Sidsolegend/CANIS/docs/images/01-prototype-chassis-side.jpg

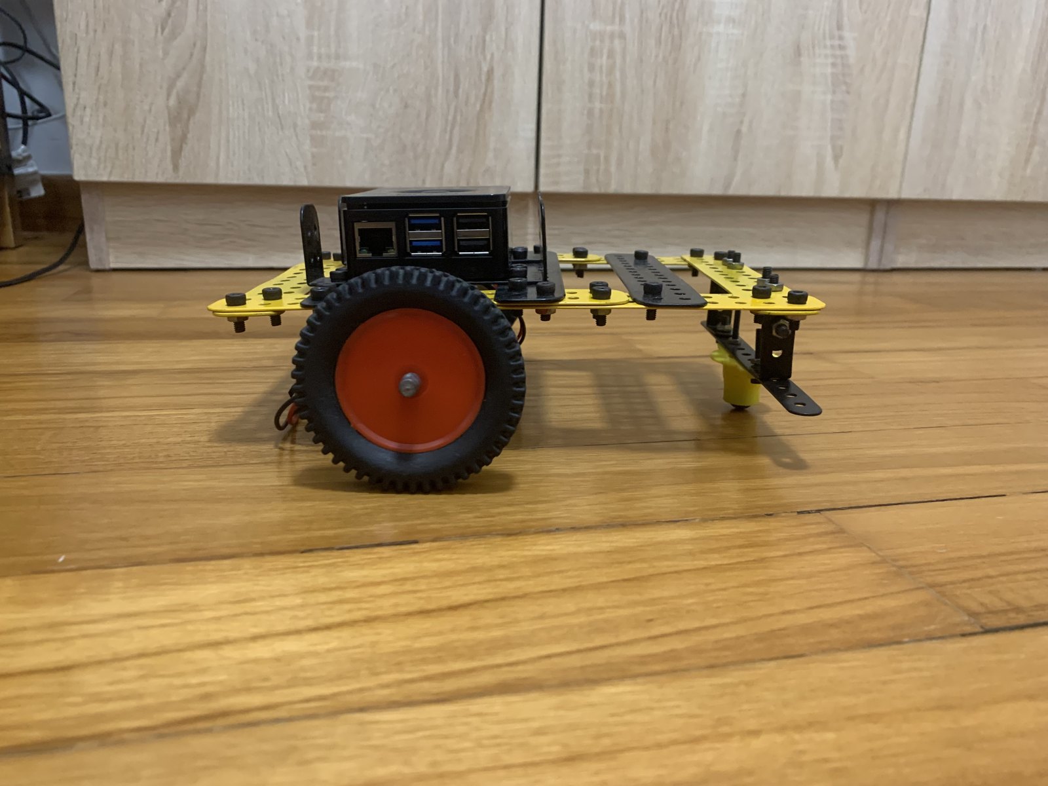
docs/images/01-prototype-chassis-side.jpg
