Sidsolegend/CANIS/hardware/cad/preview_v4/v4_shell_front.png

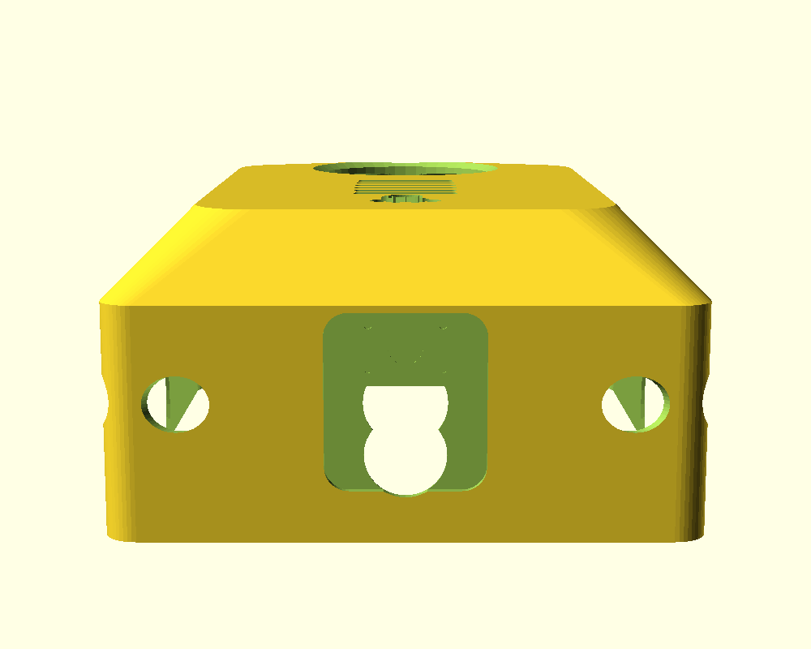
hardware/cad/preview_v4/v4_shell_front.png
