Sidsolegend/CANIS/hardware/cad/preview_v4/v4_shell_iso.png

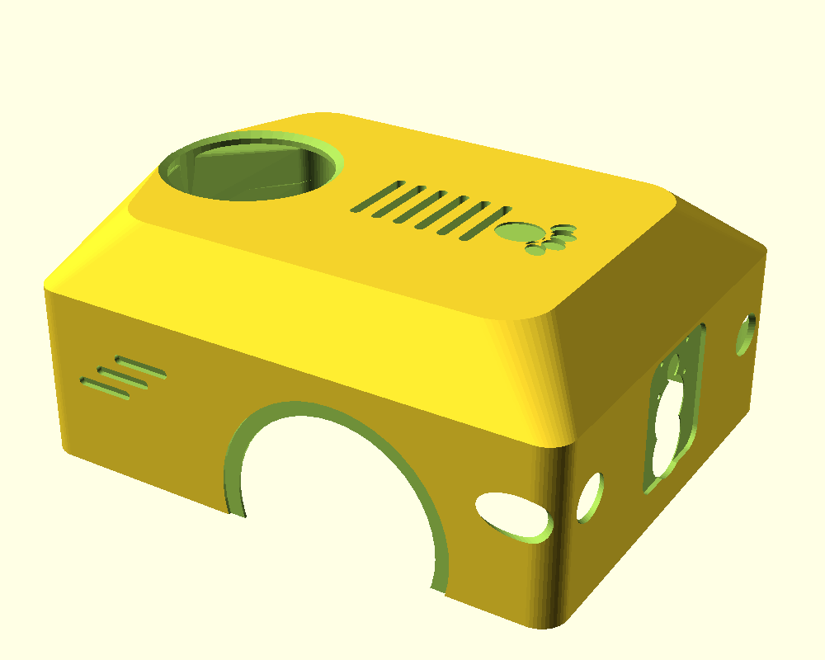
hardware/cad/preview_v4/v4_shell_iso.png
