Sidsolegend/CANIS/hardware/cad/preview_v4/v4_shell_top.png

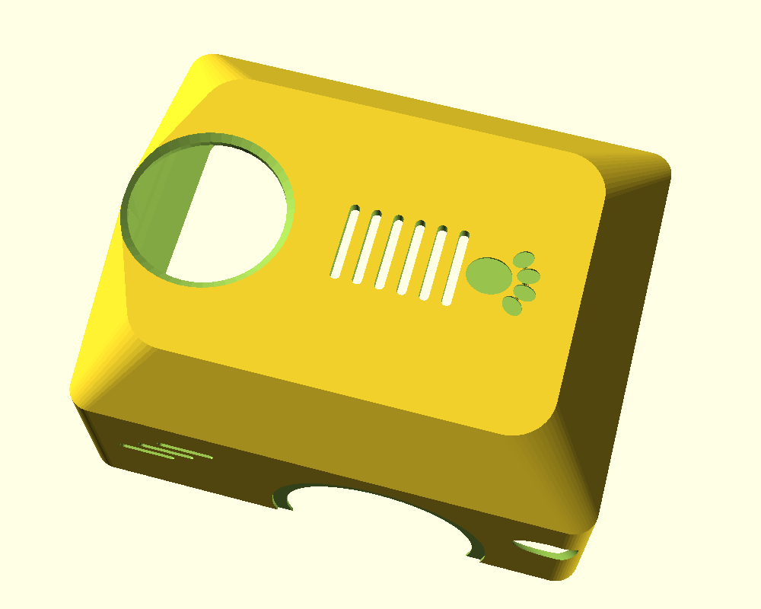
hardware/cad/preview_v4/v4_shell_top.png
