Sidsolegend/CANIS/hardware/cad/renders_v4_front.png

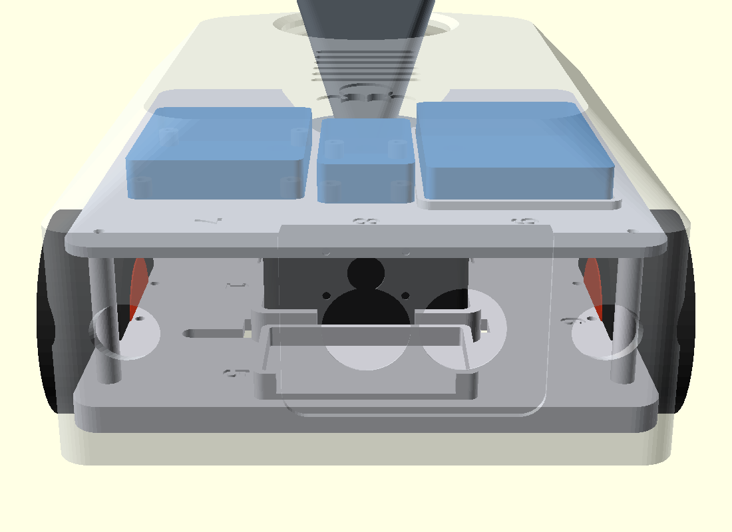
hardware/cad/renders_v4_front.png
