Sidsolegend/CANIS/hardware/cad/renders_v4_plate.png

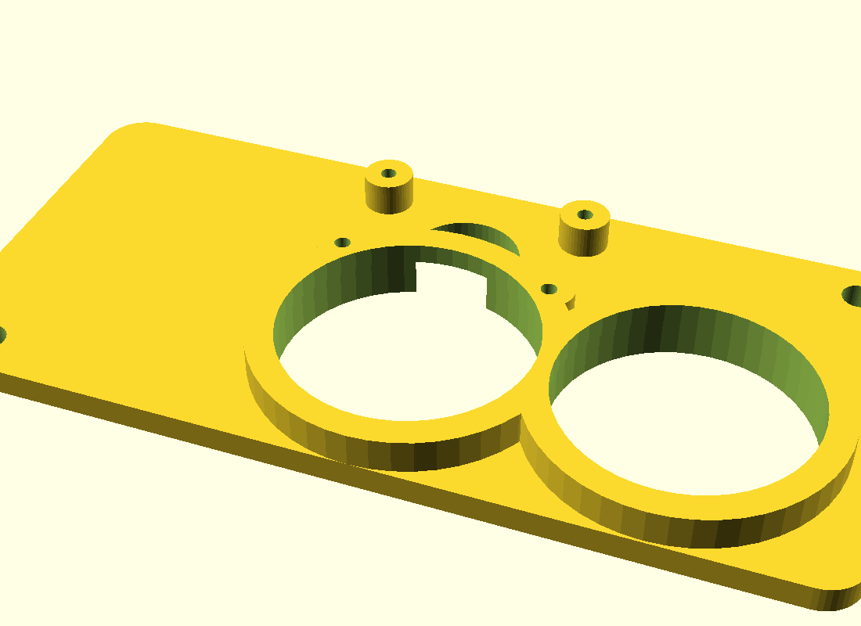
hardware/cad/renders_v4_plate.png
