Sidsolegend/CANIS/hardware/pcb/canis_main_preview.png

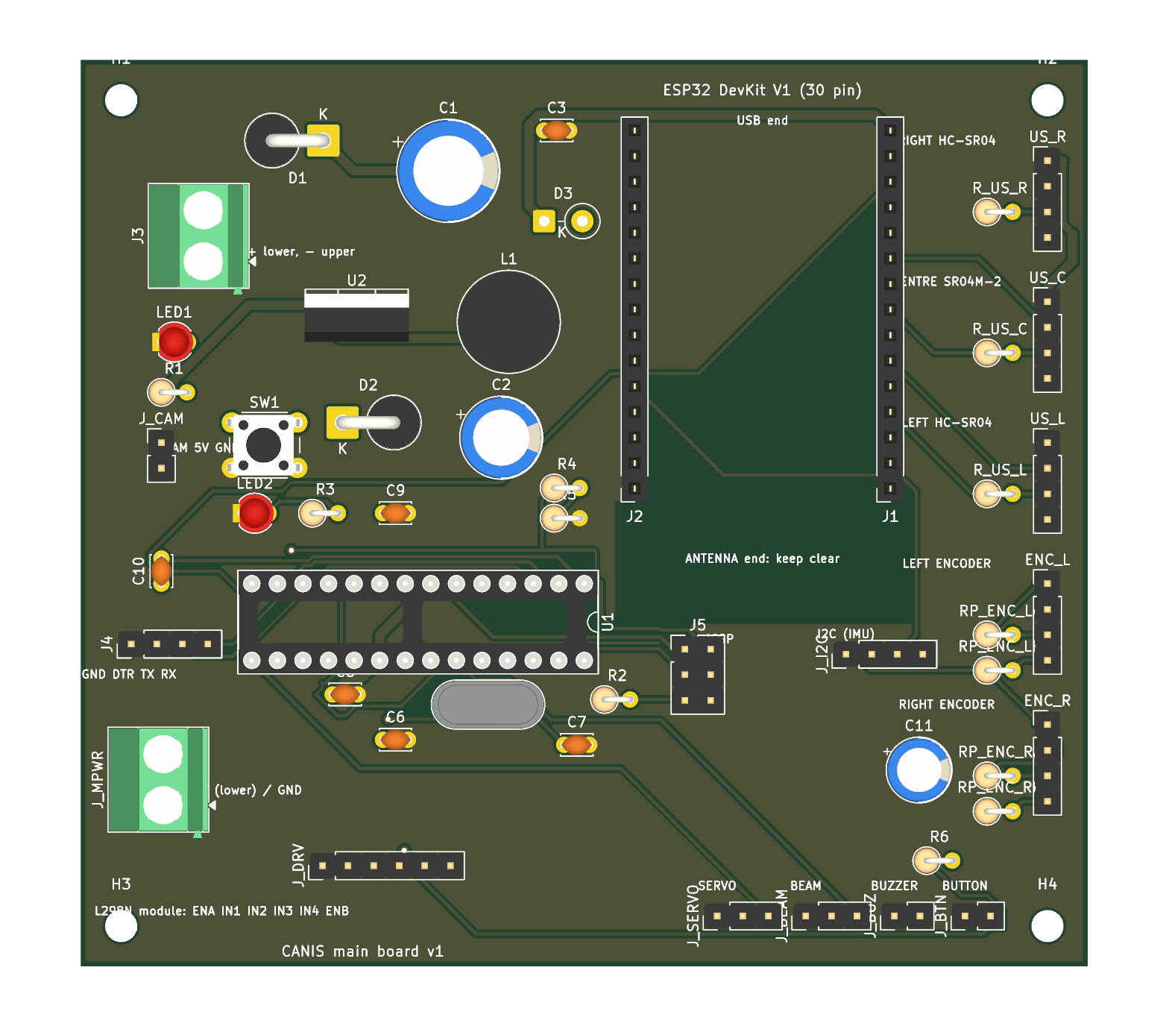
hardware/pcb/canis_main_preview.png
