Sidsolegend/CANIS/hardware/cad/stl/canis_all.stl

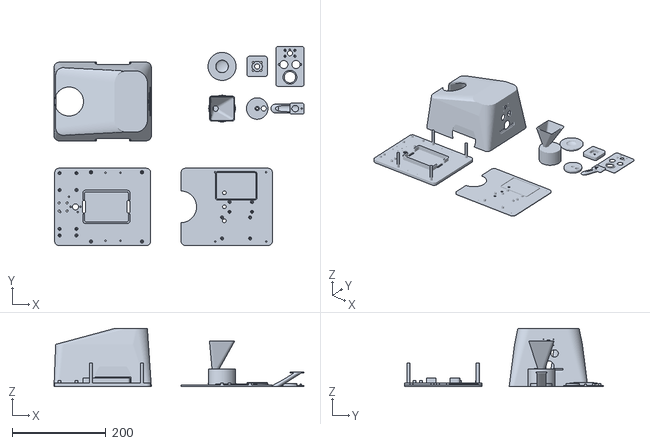
[picture p18: CAD file, 2026-10-11]
hardware/cad/stl/canis_all.stl
534.0 x 425.0 x 124.0
