Sidsolegend/CANIS/hardware/cad/stl_v4/lid.stl

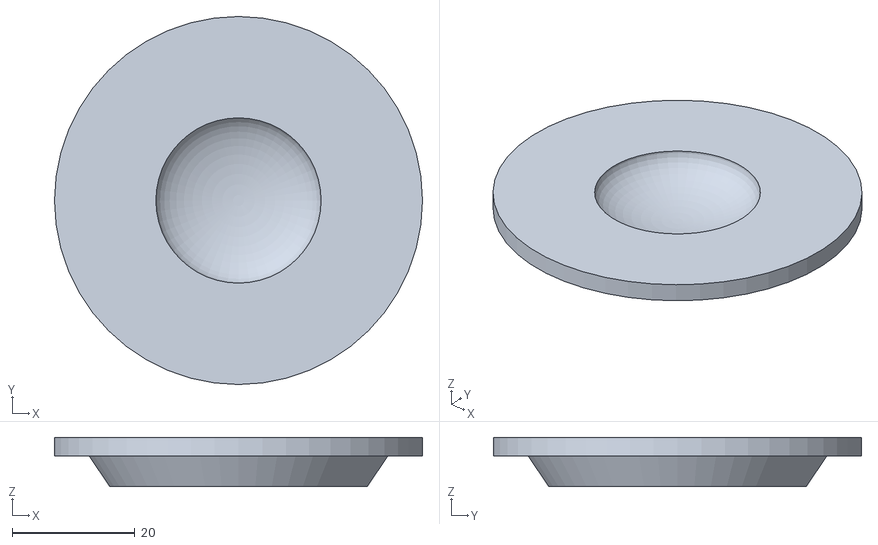
[picture p19: CAD file, 2026-10-11]
hardware/cad/stl_v4/lid.stl
60.0 x 60.0 x 8.00
