Sidsolegend/CANIS/hardware/cad/stl/chute.stl

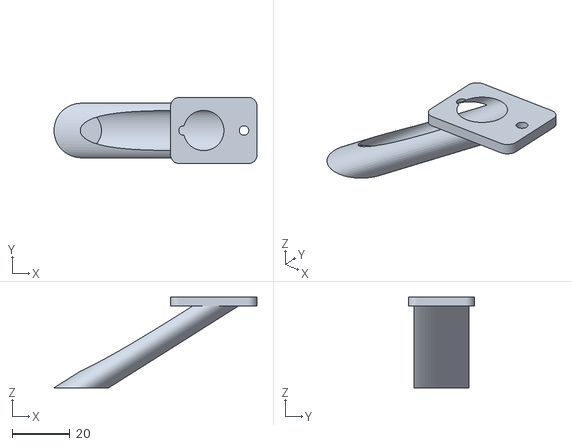
[picture p21: CAD file, 2026-06-29]
hardware/cad/stl/chute.stl
70.5 x 23.0 x 31.5
