Sidsolegend/CANIS/hardware/cad/stl_v4/shell_B.stl

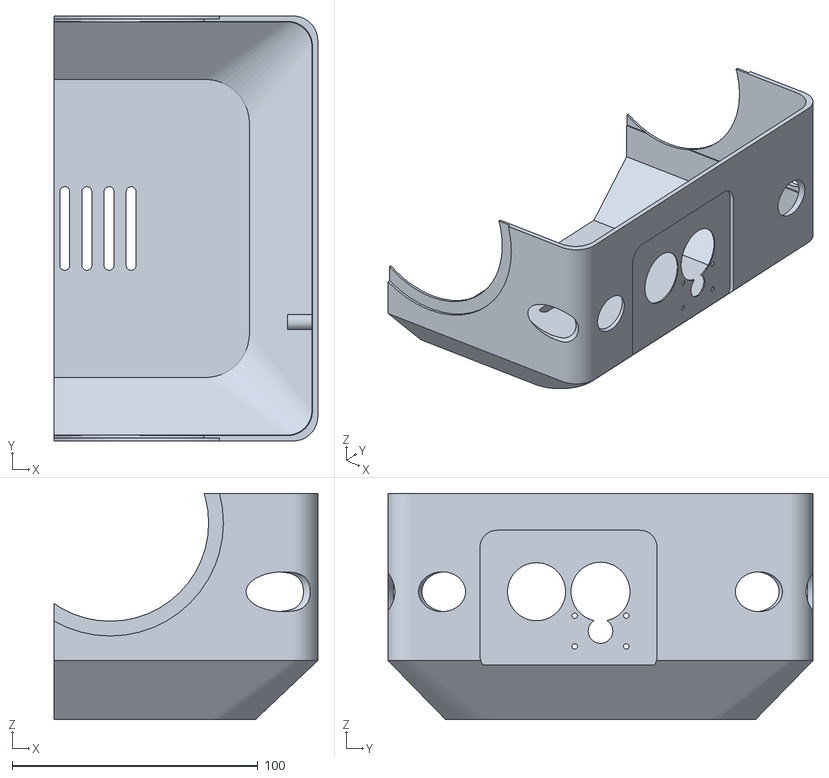
[picture p22: CAD file, 2026-10-11]
hardware/cad/stl_v4/shell_B.stl
107.2 x 172.8 x 92.0
