Sidsolegend/CANIS/hardware/cad/stl/shelf.stl

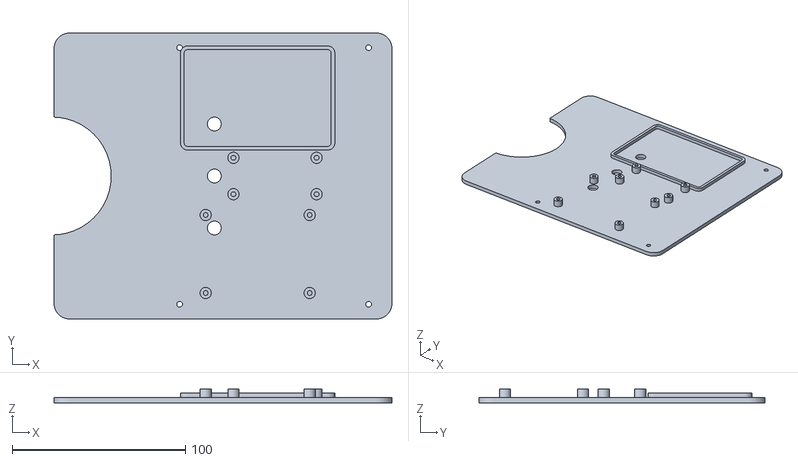
[picture p23: CAD file, 2026-06-29]
hardware/cad/stl/shelf.stl
195.0 x 165.0 x 8.00
