Sidsolegend/CANIS/printables/deck_onepiece.gcode.3mf

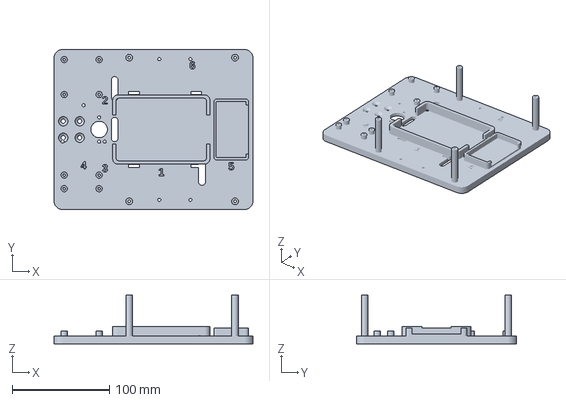
[picture p24: CAD file, 2026-07-19]
printables/deck_onepiece.gcode.3mf
205.0 x 165.0 x 50.0 mm
