Sidsolegend/CANIS/hardware/cad/stl/lid.stl

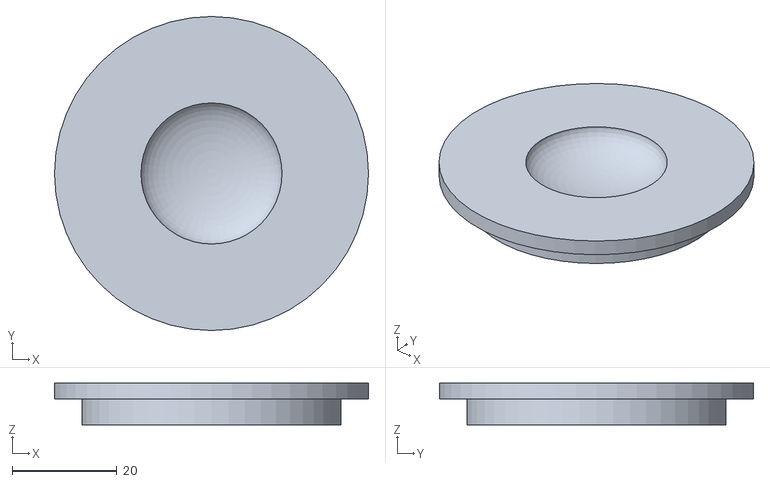
[picture p25: CAD file, 2026-06-29]
hardware/cad/stl/lid.stl
60.0 x 60.0 x 8.00
