Sidsolegend/CANIS/hardware/cad/stl_v4/shelf.stl

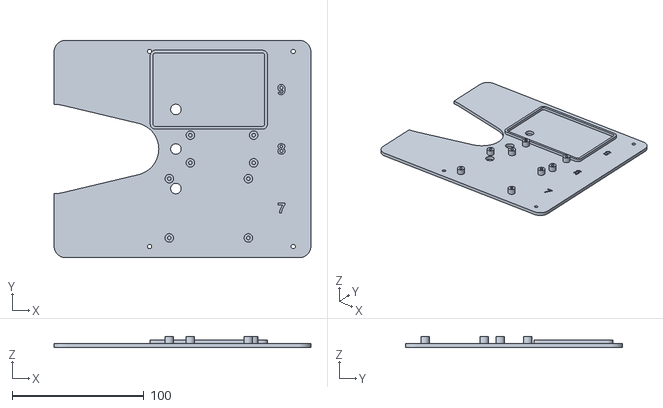
[picture p26: CAD file, 2026-10-11]
hardware/cad/stl_v4/shelf.stl
195.0 x 165.0 x 8.00
