Sidsolegend/CANIS/printables/deck_B.gcode.3mf

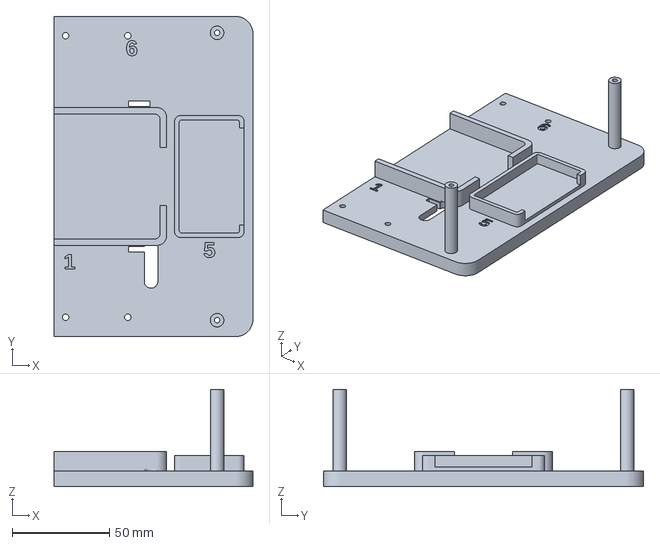
[picture p27: CAD file, 2026-07-19]
printables/deck_B.gcode.3mf
102.5 x 165.0 x 50.0 mm
