Sidsolegend/CANIS/hardware/cad/stl/shell.stl

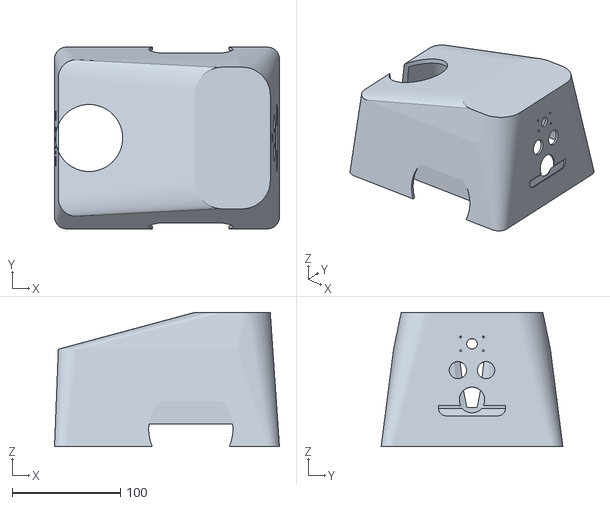
[picture p28: CAD file, 2026-06-29]
hardware/cad/stl/shell.stl
208.0 x 168.0 x 124.0
