Sidsolegend/CANIS/hardware/cad/stl_v4/shell.stl

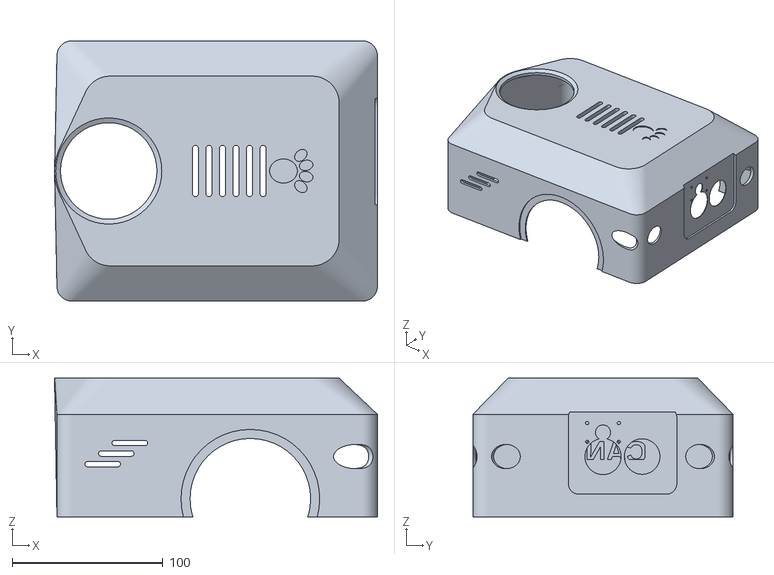
[picture p29: CAD file, 2026-10-11]
hardware/cad/stl_v4/shell.stl
214.4 x 172.8 x 92.0
