Sidsolegend/CANIS/hardware/cad/stl/deck.stl

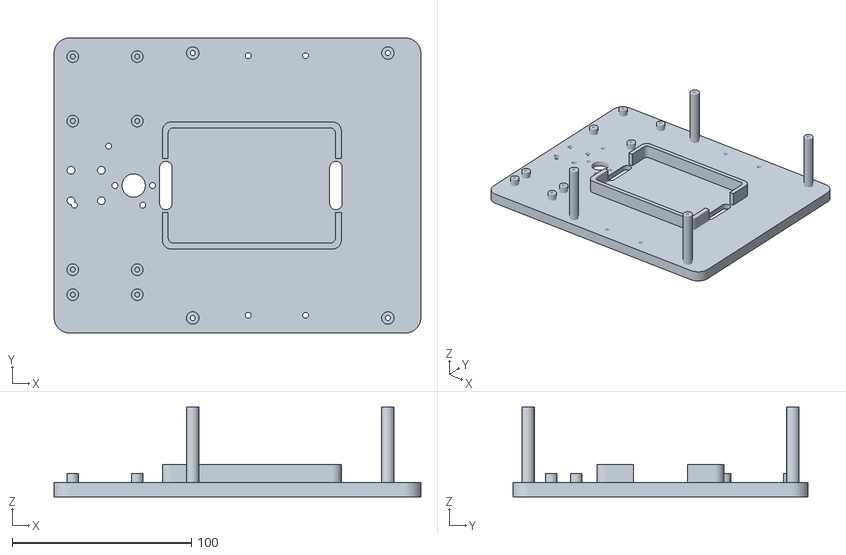
[picture p30: CAD file, 2026-06-29]
hardware/cad/stl/deck.stl
205.0 x 165.0 x 50.0
