Sidsolegend/CANIS/hardware/cad/stl_v4/dispenser_base.stl

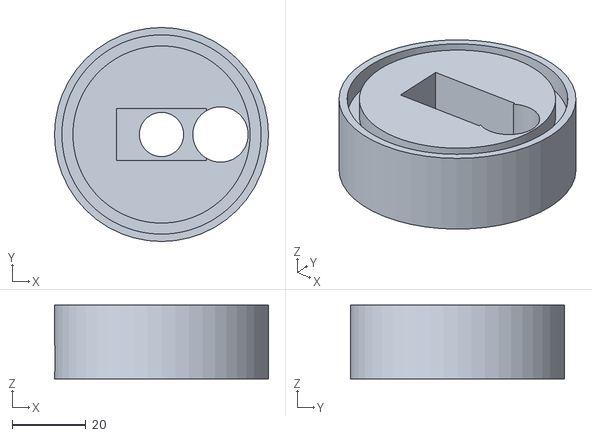
[picture p31: CAD file, 2026-10-11]
hardware/cad/stl_v4/dispenser_base.stl
58.0 x 58.0 x 20.0
