Sidsolegend/CANIS/hardware/cad/stl/disc.stl

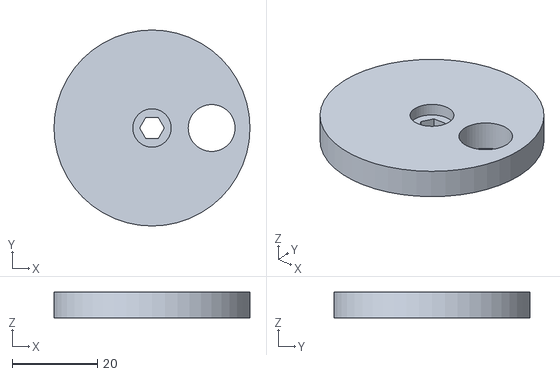
[picture p32: CAD file, 2026-06-29]
hardware/cad/stl/disc.stl
46.0 x 46.0 x 6.00
