Sidsolegend/CANIS/hardware/cad/stl/dispenser.stl

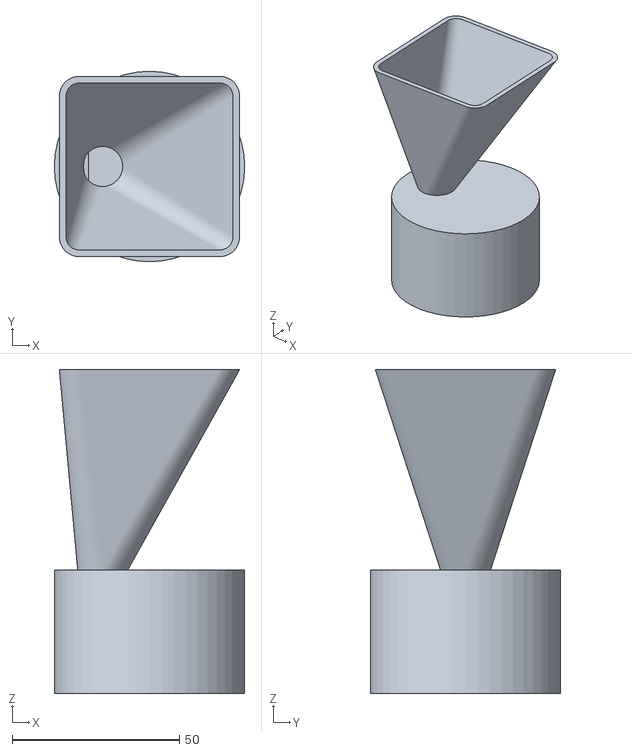
[picture p33: CAD file, 2026-06-29]
hardware/cad/stl/dispenser.stl
57.0 x 57.0 x 97.0
