Sidsolegend/CANIS/hardware/cad/stl/castor.stl

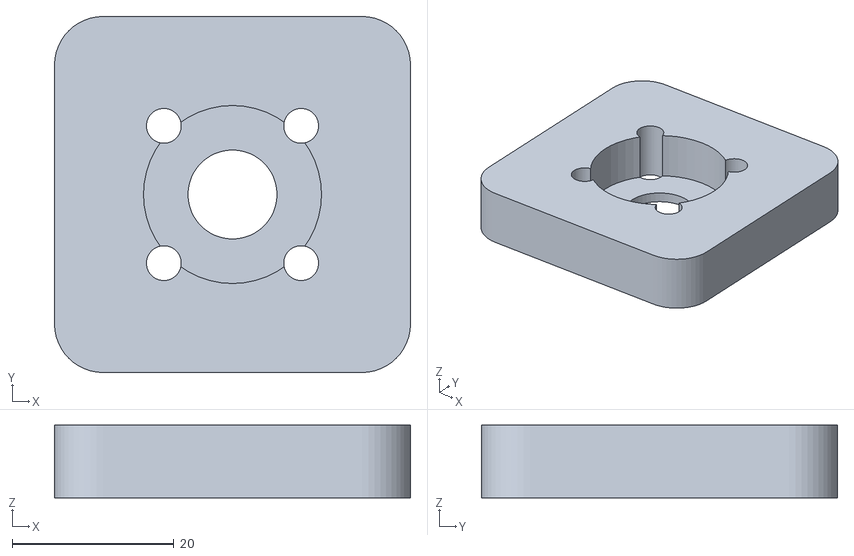
[picture p34: CAD file, 2026-06-29]
hardware/cad/stl/castor.stl
44.0 x 44.0 x 9.00
