Sidsolegend/CANIS/hardware/cad/stl/sensor_plate.stl

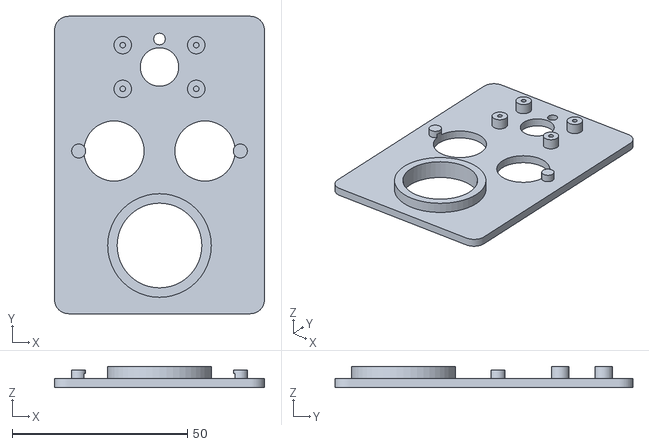
[picture p35: CAD file, 2026-06-29]
hardware/cad/stl/sensor_plate.stl
60.0 x 85.0 x 6.00
