Sidsolegend/CANIS/hardware/cad/stl_v4/shell_A.stl

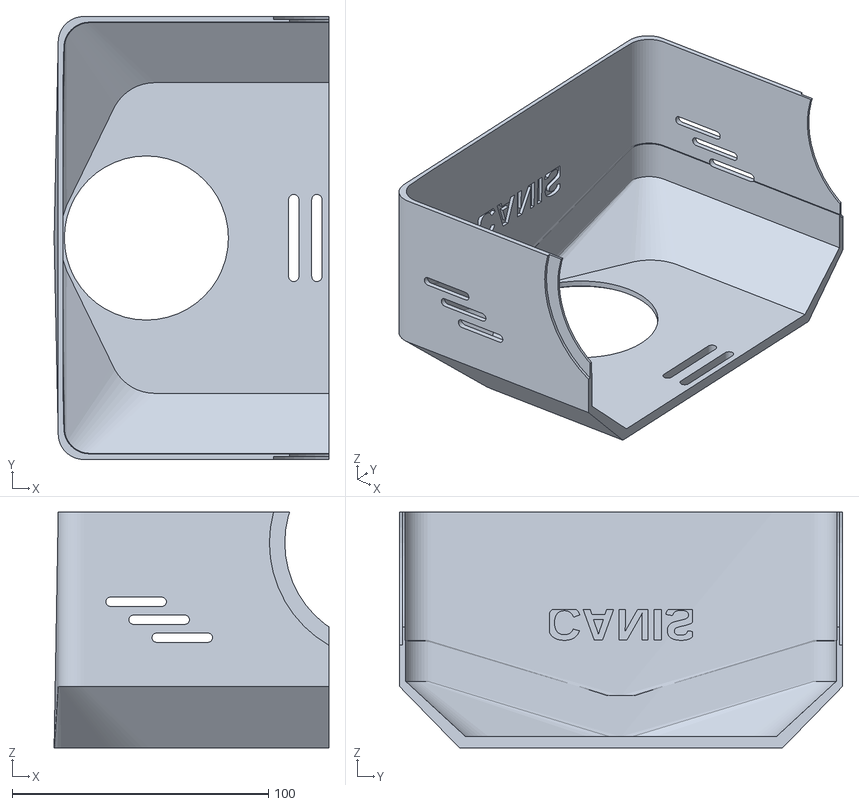
[picture p36: CAD file, 2026-10-11]
hardware/cad/stl_v4/shell_A.stl
107.2 x 172.8 x 92.0
