Sidsolegend/CANIS/hardware/cad/stl_v4/flap.stl

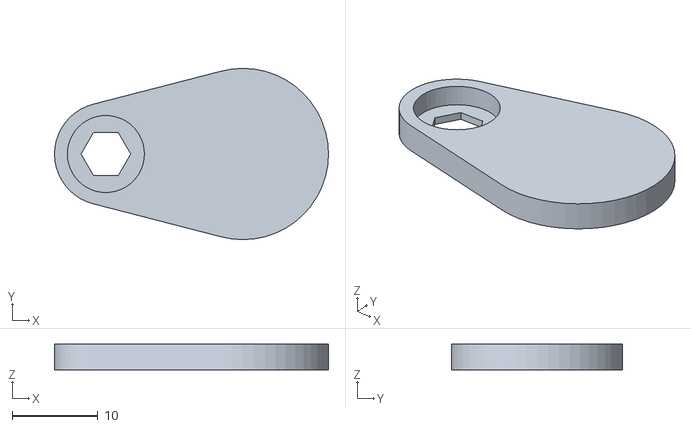
[picture p37: CAD file, 2026-10-11]
hardware/cad/stl_v4/flap.stl
32.0 x 20.0 x 3.00
