Sidsolegend/CANIS/hardware/cad/stl_v4/castor.stl

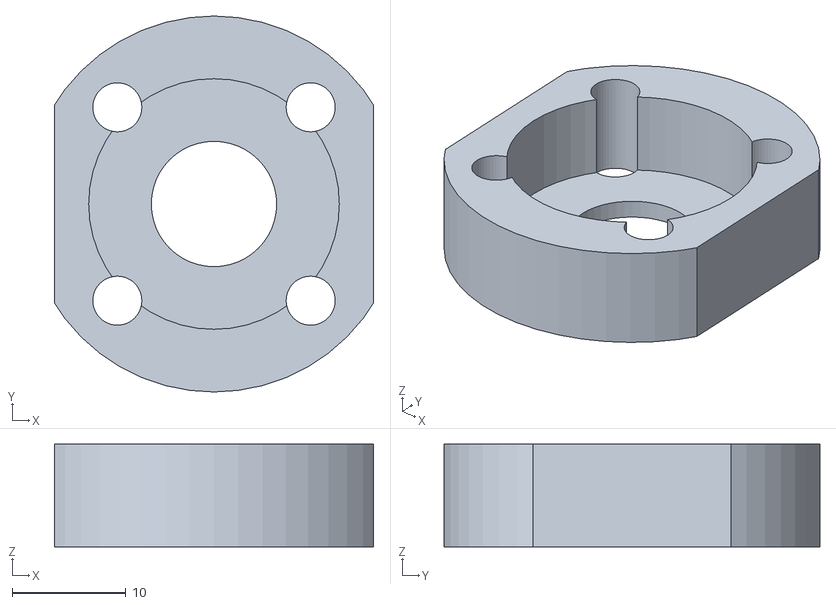
[picture p38: CAD file, 2026-10-11]
hardware/cad/stl_v4/castor.stl
28.0 x 33.0 x 9.00
