Sidsolegend/CANIS/hardware/cad/stl_v4/chute_print.stl

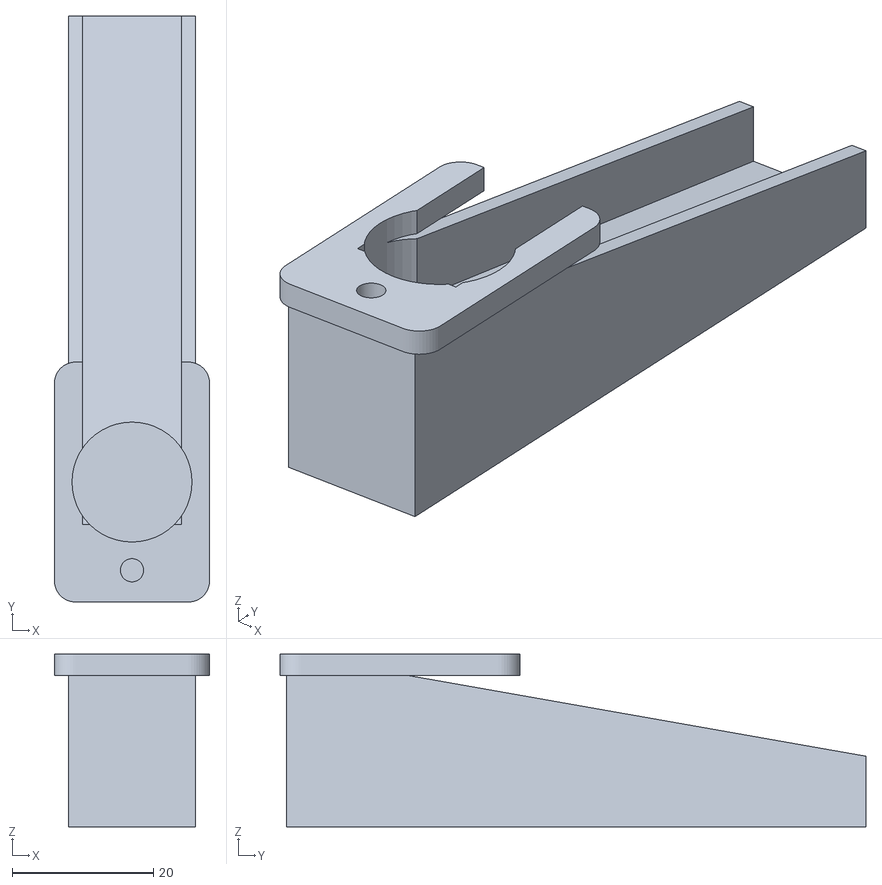
[picture p39: CAD file, 2026-10-11]
hardware/cad/stl_v4/chute_print.stl
22.0 x 83.0 x 24.5
