Sidsolegend/CANIS/hardware/cad/stl_v4/sensor_plate.stl

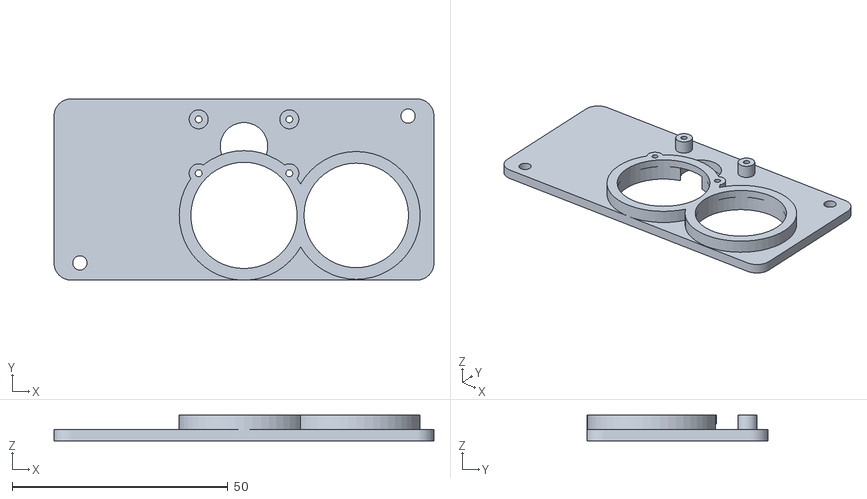
[picture p40: CAD file, 2026-10-11]
hardware/cad/stl_v4/sensor_plate.stl
88.0 x 42.0 x 6.00
