Sidsolegend/CANIS/hardware/cad/stl_v4/shelf_plain.stl

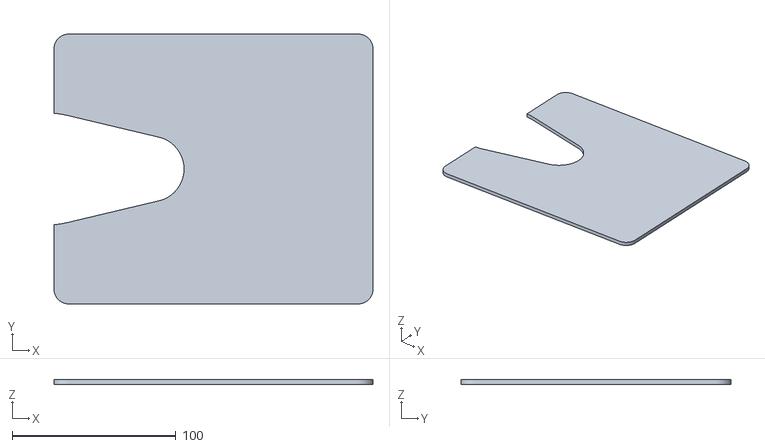
[picture p41: CAD file, 2026-10-11]
hardware/cad/stl_v4/shelf_plain.stl
195.0 x 165.0 x 3.00
