Sidsolegend/CANIS/hardware/cad/stl_v4/dispenser.stl

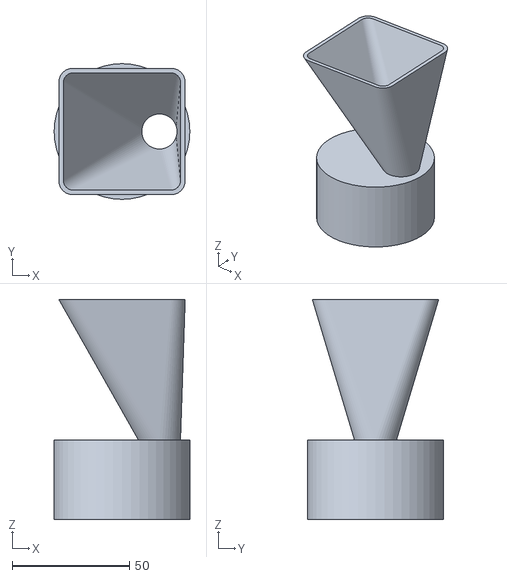
[picture p42: CAD file, 2026-10-11]
hardware/cad/stl_v4/dispenser.stl
58.0 x 58.0 x 94.0
