Sidsolegend/CANIS/hardware/cad/stl_v4/dispenser_top.stl

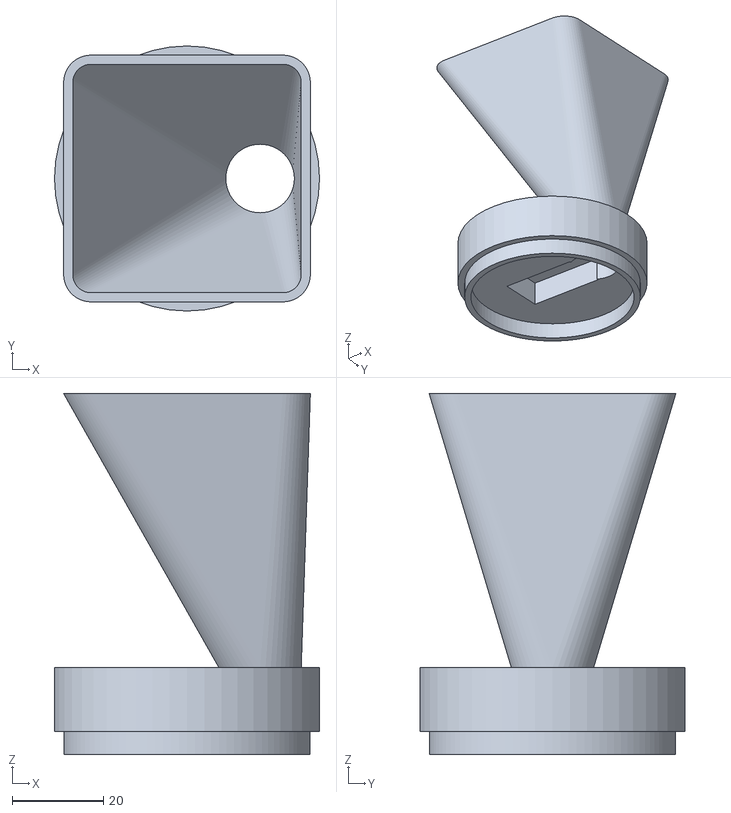
[picture p43: CAD file, 2026-10-11]
hardware/cad/stl_v4/dispenser_top.stl
58.0 x 58.0 x 79.0
