Sidsolegend/CANIS/(list of files, cad)

Other CAD files:
printables/castor_chute.gcode.3mf
hardware/cad/stl_v4/deck_A.stl
printables/shell_onepiece.gcode.3mf
printables/lid_sensor.gcode.3mf
hardware/cad/stl_v4/deck.stl
printables/dispenser.gcode.3mf
hardware/cad/stl_v4/deck_B.stl
printables/castor.gcode.3mf
hardware/cad/stl_v4/shell_print.stl
printables/lid.gcode.3mf
printables/shell.gcode.3mf
printables/shelf.gcode.3mf
printables/deck.gcode.3mf
printables/sensor_plate.gcode.3mf
hardware/cad/stl_v4/chute.stl
hardware/cad/stl_v4/lid_print.stl
hardware/cad/archive/canis.scad
hardware/cad/archive/canis_v2.scad
hardware/cad/archive/canis_v3.scad
hardware/cad/archive/printables/castor.gcode.3mf
hardware/cad/archive/printables/castor_chute.gcode.3mf
hardware/cad/archive/printables/deck.gcode.3mf
hardware/cad/archive/printables/dispenser.gcode.3mf
hardware/cad/archive/printables/lid.gcode.3mf
hardware/cad/archive/printables/lid_sensor.gcode.3mf
hardware/cad/archive/printables/sensor_plate.gcode.3mf
hardware/cad/archive/printables/shelf.gcode.3mf
hardware/cad/archive/printables/shell.gcode.3mf
hardware/cad/archive/printables/shell_onepiece.gcode.3mf
hardware/cad/archive/stl/canis_all.stl
hardware/cad/archive/stl_v2/castor.stl
hardware/cad/archive/stl_v2/chute.stl
hardware/cad/archive/stl_v2/deck.stl
hardware/cad/archive/stl_v2/dispenser.stl
hardware/cad/archive/stl_v2/flap.stl
hardware/cad/archive/stl_v2/lid.stl
hardware/cad/archive/stl_v2/sensor_plate.stl
hardware/cad/archive/stl_v2/shelf.stl
hardware/cad/archive/stl_v2/shell.stl
hardware/cad/archive/stl_v3/shell.stl
hardware/cad/canis_v2.scad
hardware/cad/stl_v2/castor.stl
hardware/cad/stl_v2/chute.stl
hardware/cad/stl_v2/deck.stl
hardware/cad/stl_v2/dispenser.stl
hardware/cad/stl_v2/flap.stl
hardware/cad/stl_v2/lid.stl
hardware/cad/stl_v2/sensor_plate.stl
hardware/cad/stl_v2/shelf.stl
hardware/cad/stl_v2/shell.stl
hardware/cad/stl_v3/shell.stl
