Sidsolegend/CANIS/hardware/cad/preview_v4/v4_assembly_rear.png

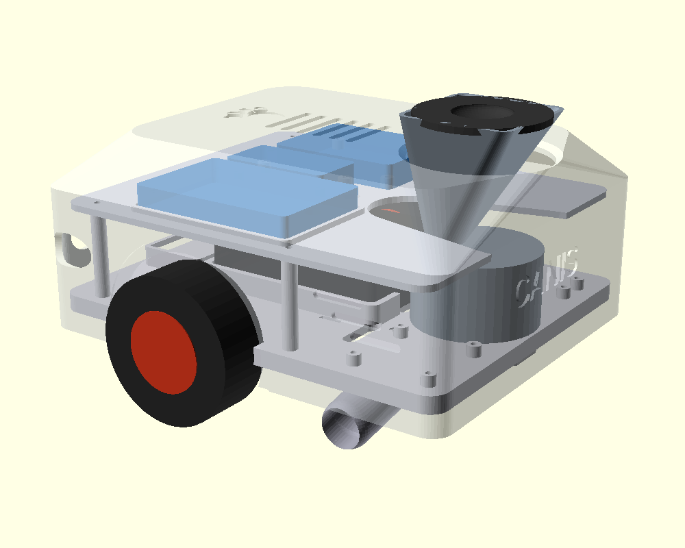
hardware/cad/preview_v4/v4_assembly_rear.png
