Sidsolegend/CANIS/hardware/pcb/canis_main_testprint_1to1.pdf

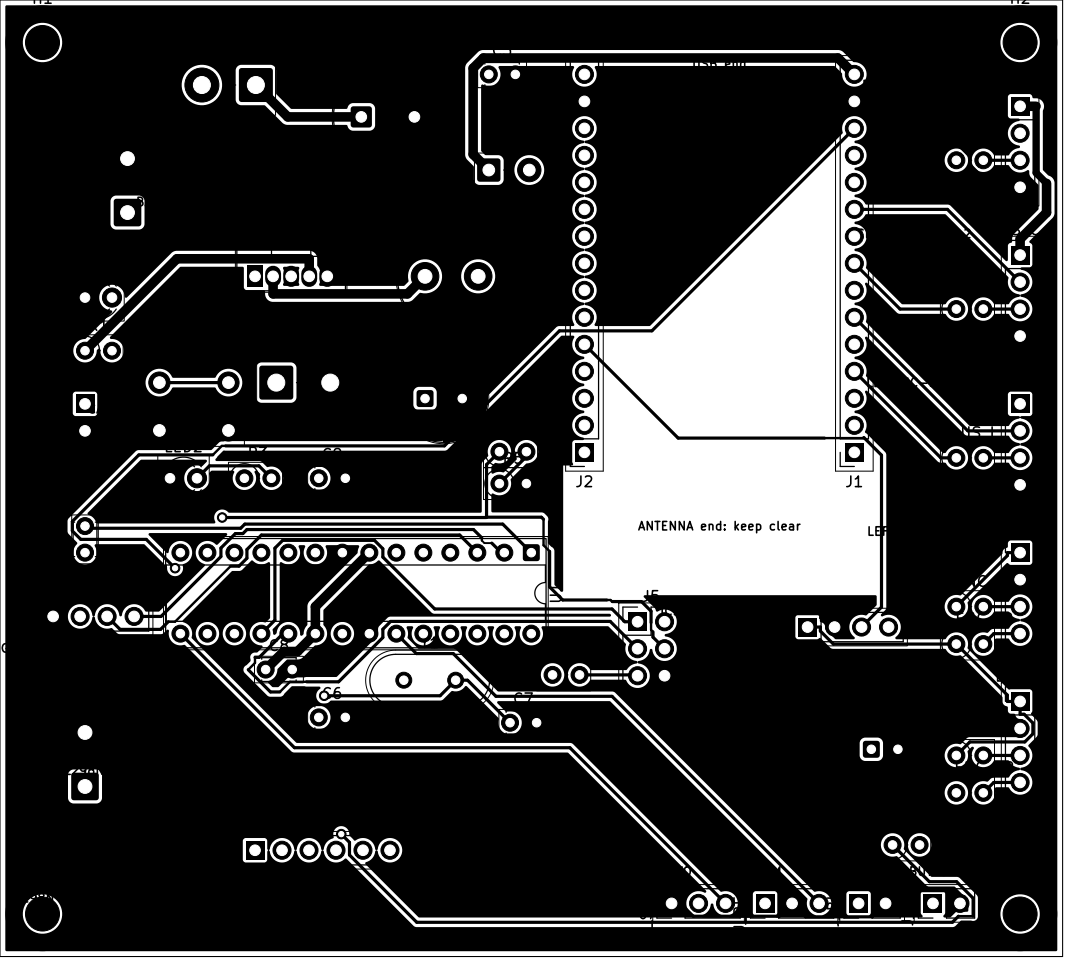
[picture p45: page 1]

ANTENNA end: keep clear BEAM
RP_ENC_LA J_BTN
I2C (IMU)BUZZER

BUTTON CANIS main board v1
