Sidsolegend/CANIS/hardware/pcb/canis_main.kicad_pcb

## KiCad design hardware/pcb/canis_main.kicad_pcb (2026-10-13)

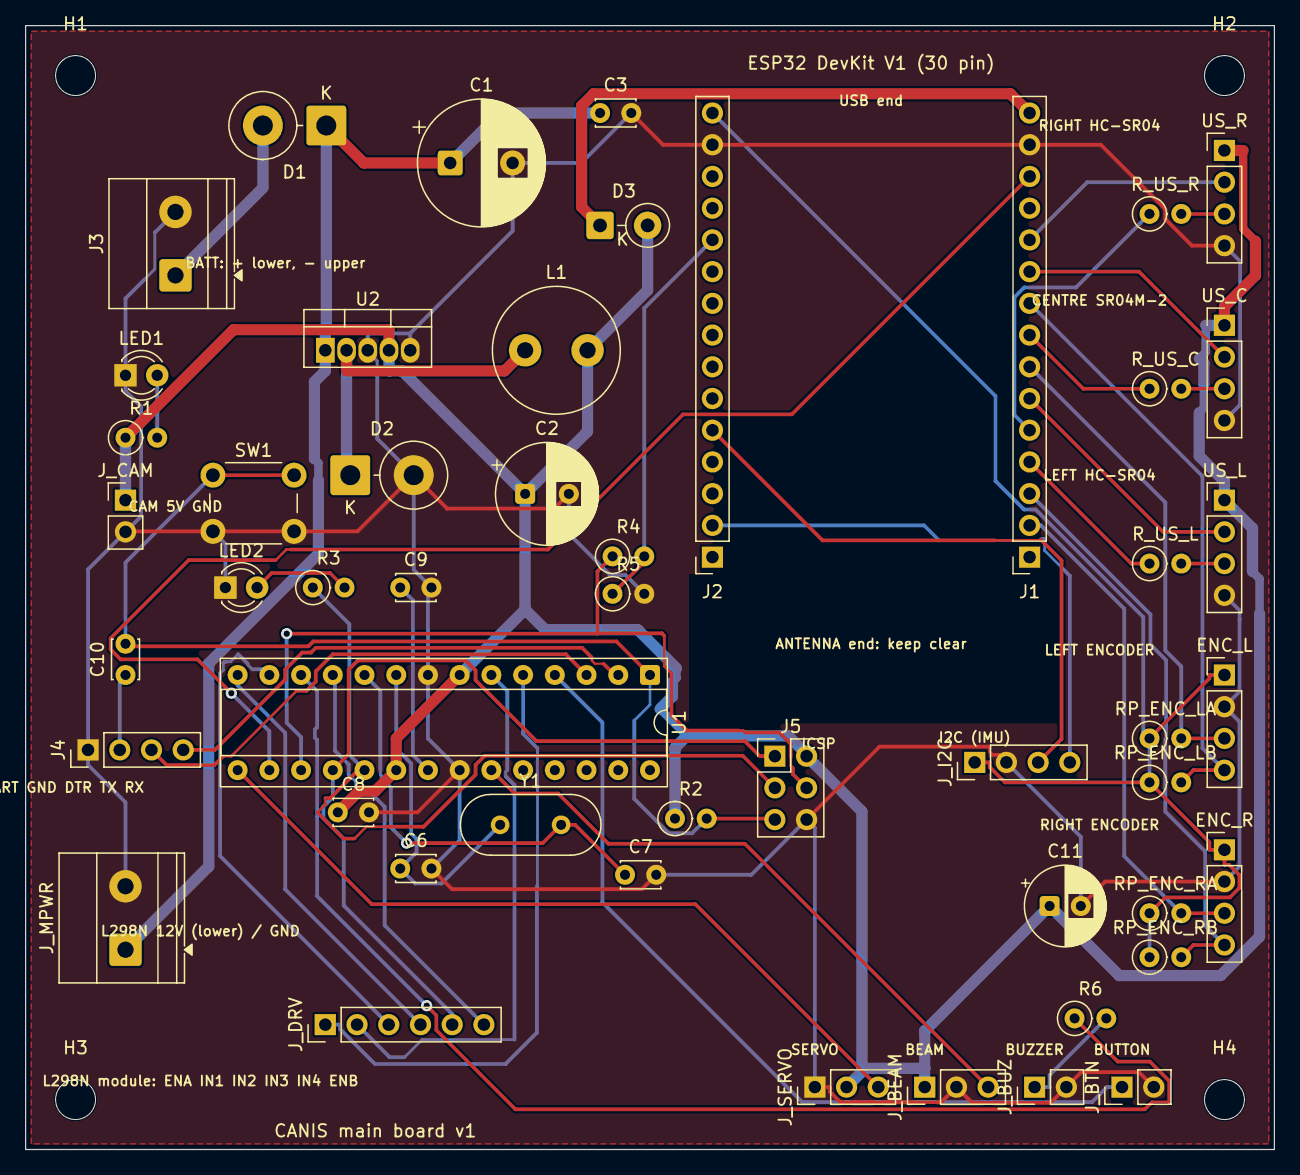
[picture p46: board canis_main.kicad_pcb from above]

Board: 2 copper layers, 100.0 x 90.0 mm, 54 parts (0 on the bottom side), 46 nets.

Parts:
C1: 470u 25V; CP_Radial_D10.0mm_P5.00mm
C2: 470u 16V (5V out); CP_Radial_D8.0mm_P3.50mm
C3: 100n; C_Disc_D3.0mm_W2.0mm_P2.50mm
C6, C7: 22p; C_Disc_D3.0mm_W2.0mm_P2.50mm
C8: 100n VCC; C_Disc_D3.0mm_W2.0mm_P2.50mm
C9: 100n AREF; C_Disc_D3.0mm_W2.0mm_P2.50mm
C10: 100n DTR; C_Disc_D3.0mm_W2.0mm_P2.50mm
C11: 220u servo; CP_Radial_D6.3mm_P2.50mm
D1: 1N5822 reverse protect; D_DO-201AD_P5.08mm_Vertical_CathodeUp
D2: 1N5822 buck; D_DO-201AD_P5.08mm_Vertical_CathodeUp
D3: 1N5819 5V->VIN; D_DO-41_SOD81_P3.81mm_Vertical_CathodeUp
ENC_L: LEFT ENCODER 3V3 GND A B; PinHeader_1x04_P2.54mm_Vertical
ENC_R: RIGHT ENCODER 3V3 GND A B; PinHeader_1x04_P2.54mm_Vertical
H1, H2, H3, H4: M3; MountingHole_3.2mm_M3
J1: ESP32 DevKit left header (EN..VIN); PinSocket_1x15_P2.54mm_Vertical
J2: ESP32 DevKit right header (D23..3V3); PinSocket_1x15_P2.54mm_Vertical
J3: BATT 6xAA; TerminalBlock_Phoenix_MKDS-1,5-2-5.08_1x02_P5.08mm_Horizont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
J4: UART (FTDI/CP2102) GND DTR TXD RXD; PinHeader_1x04_P2.54mm_Vertical
J5: ICSP; PinHeader_2x03_P2.54mm_Vertical
J_BEAM: BEAM 5V GND OUT; PinHeader_1x03_P2.54mm_Vertical
J_BTN: BUTTON D2 GND; PinHeader_1x02_P2.54mm_Vertical
J_BUZ: BUZZER SIG GND; PinHeader_1x02_P2.54mm_Vertical
J_CAM: ESP32-CAM 5V GND; PinHeader_1x02_P2.54mm_Vertical
J_DRV: TO L298N module: ENA IN1 IN2 IN3 IN4 ENB; PinHeader_1x06_P2.54mm_Vertical
J_I2C: I2C 3V3 GND SDA SCL; PinHeader_1x04_P2.54mm_Vertical
J_MPWR: TO L298N 12V / GND; TerminalBlock_Phoenix_MKDS-1,5-2-5.08_1x02_P5.08mm_Horizont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
J_SERVO: SERVO GND 5V SIG; PinHeader_1x03_P2.54mm_Vertical
L1: 33uH 3A; L_Radial_D10.0mm_P5.00mm_Fastron_07P
LED1: green 5V; LED_D3.0mm
LED2: amber D13; LED_D3.0mm
R1, R3, R4: 1k; R_Axial_DIN0207_L6.3mm_D2.5mm_P2.54mm_Vertical
R2: 10k reset; R_Axial_DIN0207_L6.3mm_D2.5mm_P2.54mm_Vertical
R5: 2.2k; R_Axial_DIN0207_L6.3mm_D2.5mm_P2.54mm_Vertical
R6: 220; R_Axial_DIN0207_L6.3mm_D2.5mm_P2.54mm_Vertical
RP_ENC_LA: 10k; R_Axial_DIN0207_L6.3mm_D2.5mm_P2.54mm_Vertical
RP_ENC_LB: 10k; R_Axial_DIN0207_L6.3mm_D2.5mm_P2.54mm_Vertical
RP_ENC_RA: 10k; R_Axial_DIN0207_L6.3mm_D2.5mm_P2.54mm_Vertical
RP_ENC_RB: 10k; R_Axial_DIN0207_L6.3mm_D2.5mm_P2.54mm_Vertical
R_US_C: 1k; R_Axial_DIN0207_L6.3mm_D2.5mm_P2.54mm_Vertical
R_US_L: 1k; R_Axial_DIN0207_L6.3mm_D2.5mm_P2.54mm_Vertical
R_US_R: 1k; R_Axial_DIN0207_L6.3mm_D2.5mm_P2.54mm_Vertical
SW1: RESET; SW_PUSH_6mm
U1: ATmega328P-PU (Uno bootloader); DIP-28_W7.62mm_Socket
U2: LM2596T-5.0; TO-220-5_Vertical
US_C: CENTRE SR04M-2 5V TRIG ECHO GND; PinHeader_1x04_P2.54mm_Vertical
US_L: LEFT HC-SR04 5V TRIG ECHO GND; PinHeader_1x04_P2.54mm_Vertical
US_R: RIGHT HC-SR04 5V TRIG ECHO GND; PinHeader_1x04_P2.54mm_Vertical
Y1: 16 MHz; Crystal_HC49-4H_Vertical

Connections:
3V3: ENC_L.1, ENC_R.1, J2.15, J_I2C.1, RP_ENC_LA.1, RP_ENC_LB.1, RP_ENC_RA.1, RP_ENC_RB.1
5V: C2.1, C8.1, C11.1, D3.2, J5.2, J_BEAM.1, J_CAM.1, J_SERVO.2, L1.2, R1.1, R2.1, U1.7, U1.20, U2.4, US_C.1, US_L.1, US_R.1
AREF: C9.1, U1.21
BEAM: J_BEAM.3, U1.23
BTN: J_BTN.1, U1.4
BUZ: J_BUZ.1, R6.2
BUZ_RAW: R6.1, U1.12
D0_RX: J4.4, U1.2
D1_TX: J4.3, U1.3
D13_LED: J5.3, R3.1, U1.19
DTR: C10.1, J4.2
ENC_L_A: ENC_L.3, J1.7, RP_ENC_LA.2
ENC_L_B: ENC_L.4, J1.9, RP_ENC_LB.2
ENC_R_A: ENC_R.3, J1.2, RP_ENC_RA.2
ENC_R_B: ENC_R.4, J1.3, RP_ENC_RB.2
GND: C1.2, C2.2, C3.2, C6.2, C7.2, C8.2, C9.2, C11.2, D2.2, ENC_L.2, ENC_R.2, J1.14, J2.14, J3.2, J4.1, J5.6, J_BEAM.2, J_BTN.2, J_BUZ.2, J_CAM.2, J_I2C.2, J_MPWR.2, J_SERVO.1, LED1.1, LED2.1, R5.2, SW1.2, U1.8, U1.22, U2.3, U2.5, US_C.4, US_L.4, US_R.4
I2C_SCL: J2.2, J_I2C.4
I2C_SDA: J2.5, J_I2C.3
LED5: LED1.2, R1.2
LED13: LED2.2, R3.2
LINK_RX_AT: J1.13, U1.16
LINK_TX_AT: J5.4, R4.1, U1.17
LINK_TX_DIV: J2.11, R4.2, R5.1
M_ENA: J_DRV.1, U1.5
M_ENB: J_DRV.6, U1.11
M_IN1: J_DRV.2, U1.6
M_IN2: J_DRV.3, U1.13
M_IN3: J_DRV.4, U1.14
M_IN4: J5.1, J_DRV.5, U1.18
RESET: C10.2, J5.5, R2.2, SW1.1, U1.1
SERVO: J_SERVO.3, U1.15
SW: D2.1, L1.1, U2.2
US_C_ECHO: J1.8, R_US_C.1
US_C_ECHO_RAW: R_US_C.2, US_C.3
US_C_TRIG: J1.10, US_C.2
US_L_ECHO: J1.4, R_US_L.1
US_L_ECHO_RAW: R_US_L.2, US_L.3
US_L_TRIG: J1.6, US_L.2
US_R_ECHO: J1.5, R_US_R.1
US_R_ECHO_RAW: R_US_R.2, US_R.3
US_R_TRIG: J1.11, US_R.2
VBAT: D1.2, J3.1
VIN_ESP: D3.1, J1.15
VMOT: C1.1, C3.1, D1.1, J_MPWR.1, U2.1
XTAL1: C6.1, U1.9, Y1.1
XTAL2: C7.1, U1.10, Y1.2
