Sidsolegend/CANIS/(commit log)

2026-06-25 Initial commit: CANIS conditioning robot
    Working closed loop: sensors -> state machine -> dispense + buzzer cue,
    with live ESP32->Pi dashboard. Credentials kept out of git via
    arduino_secrets.h (gitignored).
    Subsystems:
    - CANIS_Core: integrated ESP32 brain (PIR + ultrasonic, arousal state
    machine, treat dispense, CORRECTION buzzer cue, reward cooldown/cap,
    WiFi push to dashboard)
    - Treat_Dispenser_CANIS: Arduino dispenser (button + serial DISPENSE)
    - dashboard: Flask state dashboard (live ESP32 data, simulator fallback)
    - diagnostics: WiFi_Scan_Test, WiFi_Connect_Test, Sensors_Test
    - State_Machine_CANIS / State_Machine_WiFi: standalone references
    [CANIS_Core.ino, Sensors_Test.ino, State_Machine_CANIS.ino, State_Machine_WiFi.ino, Treat_Dispenser_CANIS.ino, WiFi_Connect_Test.ino, WiFi_Scan_Test.ino]
2026-06-25 Docs: update setup for arduino_secrets.h credential flow
2026-06-25 Add Pi->ESP32 vision command channel (/detect, /command) + ArUco detection script
    - Flask: /detect (vision posts zone) + /command (ESP32 polls); TTL-based staleness
    - CANIS_Core: polls /command, folds vision detections into arousal drive, shares Pi back-off
    - vision/detect.py: ArUco marker detection -> POST zone, with --test mode (no camera needed)
    - docs: refreshed repo layout + Phase 6 status
2026-06-25 Harden CANIS_Core: fixed-buffer visionZone (no heap churn) + rollover-safe backoff
    [CANIS_Core.ino]
2026-06-25 Add hardware/WIRING.md (pinout + power architecture + L298N plan); refresh README
    - New hardware/WIRING.md: every pin, the ECHO protection, power architecture
    (USB now, battery/buck later), and the planned L298N->Arduino wiring
    - README: rate-driven arousal description (was stale +25 bump), CANIS_Core as
    the main sketch, hardware/power links, refreshed phase status
2026-06-29 Add parametric 3D-printed chassis, product shell & mounts (hardware/cad)
    Parametric OpenSCAD model (canis.scad) for the hybrid CANIS build, sized for
    a Bambu P1S in PLA. Seven printable parts + STLs + preview renders.
    - Deck (230x175): ribbed load-bearing plate with a real, collision-free home for
    every component — Pi 5 cradle, board pads (Arduino, ESP32, L298N, LM2596 buck),
    breadboard pad, dispenser/motor/castor/shell holes, cable routing.
    - Shell: product enclosure with a "paw" front that actually mounts the sensors
    (HC-SR04 frame, PIR ring, camera standoffs; spaced so the PCBs don't collide),
    wheel arches, fan grille, flush hopper hole, debossed CANIS logo, hidden screws.
    - Di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
    [canis.scad, castor_mount.stl, deck.stl, dispenser.stl, gate.stl, lid.stl, motor_bracket.stl, shell.stl]
2026-06-29 Fix layout overlaps: re-pack deck (240x185), separate servo tower, relocate shell bosses
    - Deck 230x175 -> 240x185; re-pack so NO pad/cradle/dispenser/boss overlaps.
    Breadboard pad no longer intersects the Pi cradle.
    - Dispenser: servo tower moved BEHIND the throat with an asymmetric base, so it
    no longer cuts into the funnel/throat; shell hopper opening is now an oval that
    clears funnel + tower.
    - Shell screw bosses relocated to verified-clear perimeter gaps (were landing
    under the front boards); each web now ties to its nearest wall.
    - `layout` view now draws REAL pad/cradle/tower outlines (not bare footprints)
    so overlaps actually show; verified collision-free.
    [canis.scad, castor_mount.stl, deck.stl, dispenser.stl, gate.stl, lid.stl, motor_bracket.stl, shell.stl]
2026-06-29 Fix deck ribs through throat, declutter paw mounts, clean dispenser; deck 248x190
    Geometry bugs caught by per-part close-up renders:
    - Deck: a stiffening rib ran under the throat (would block treats). Ribs moved
    clear of the throat AND all holes/slots now cut FULL depth (through ribs), so
    the throat, cable slots and screw holes are never blocked.
    - Deck mounts: boards on 4 open standoffs (deck stays open underneath), breadboard
    on a perimeter lip (open centre) — nothing covers the deck or its holes.
    - Paw: removed the ultrasonic side-rails that cluttered the PIR. Only camera
    standoffs + a PIR ring remain (far apart, can't touch); the HC-SR04 is held by
    its two cans through the sn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
    [canis.scad, castor_mount.stl, deck.stl, dispenser.stl, gate.stl, lid.stl, motor_bracket.stl, shell.stl]
2026-06-29 Rebuild as clean two-tier model (205x165): lower deck + upper shelf, modular sensor plate
    Fresh rebuild after the single-tier file accumulated geometry bugs. Simpler,
    smaller, verified part-by-part:
    - Two tiers: lower deck (Pi 5, L298N, buck, motors, castor, dispenser) + upper
    shelf on 4 standoffs (Arduino, breadboard, ESP32). Shelf has a rear notch so
    the dispenser funnel passes up through it.
    - No underside ribs (4mm plate + skirt) -> nothing crosses the throat/holes.
    - Sensors on a SEPARATE modular sensor_plate (camera standoffs + ultrasonic
    can-holes + PIR ring); shell carries only clean paw holes + 2 plate bosses.
    - Dispenser: funnel + servo on one clean peanut base (no offset/int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
    [canis.scad, castor.stl, castor_mount.stl, deck.stl, dispenser.stl, gate.stl, lid.stl, motor_bracket.stl]
2026-06-29 Clean funnel + separate servo bracket, readable logo, single combined STL
    - Dispenser is now a CLEAN funnel only (round throat + 3 feet); the servo moved
    to its own `servo_bracket` part beside the funnel, enclosed under the shell.
    No more tab/notch fighting the throat.
    - Shell hopper opening simplified to the funnel circle; CANIS logo deepened so
    it's clearly readable on the rear.
    - Shelf wire holes tidied into a clean column.
    - `part="all"` lays every part flat on one plate -> single `stl/canis_all.stl`
    (open + "split to objects" in the slicer). 9 parts total; all STLs manifold.
    [canis.scad, canis_all.stl, castor.stl, deck.stl, dispenser.stl, gate.stl, lid.stl, sensor_plate.stl]
2026-06-29 Push CANIS logo down clear of the hopper opening (now fully readable)
    [canis.scad, canis_all.stl, shell.stl]
2026-06-29 Rebuild dispenser as a working rotating-disc mechanism (servo + disc + chute)
    Replaces the non-functional funnel+gate. Now an actual mechanism:
    - dispenser = round housing + funnel; the SG90 stands upright INSIDE (shaft up),
    the disc sits on its shaft.
    - disc = one metering pocket + centre horn socket; fills under the funnel inlet
    (-x), rotates 180deg, drops one kibble through the +x exit.
    - exit drops through the deck into the chute (under the deck) -> out at floor level.
    - Removed servo_bracket/gate. Updated deck (exit hole), assembly, layout, all_parts.
    9 parts; combined canis_all.stl refreshed.
    [canis.scad, canis_all.stl, chute.stl, deck.stl, disc.stl, dispenser.stl, gate.stl, servo_bracket.stl]
2026-06-29 README: fix print-settings row (gate -> disc/chute) after dispenser rebuild
2026-06-29 Fix dispenser/chute mounting alignment (verification follow-up)
    - Dispenser feet moved inward (radius 29 -> 22) so they land in solid housing
    wall instead of half in air; deck holes follow (shared disp_pins).
    - Chute redesigned with a flat mounting flange + 2 holes; deck now has matching
    chute screw holes (shared chute_mt spacing).
    - Removed dead throat_d reference in the deck (unknown-variable warning).
    Chassis/shelf/sensor/castor/motor alignments unchanged; full assembly verified.
    [canis.scad, canis_all.stl, chute.stl, deck.stl, dispenser.stl]
2026-06-29 Add BUILD_GUIDE.md (BOM, PLA print settings, step-by-step assembly); refresh all STLs
    - New hardware/cad/BUILD_GUIDE.md: parts list, per-part PLA print settings
    (orientation/supports/walls/infill), bill of materials + fasteners, and a
    step-by-step assembly walkthrough (where each board/part goes + which screws),
    plus how the rotating-disc dispenser works and the confirm-for-your-hardware list.
    - Re-exported all 9 individual STLs fresh.
    - Linked the guide from the README.
    [castor.stl, chute.stl, deck.stl, disc.stl, dispenser.stl, lid.stl, sensor_plate.stl, shelf.stl]
2026-06-29 Fix chute: continuous channel (vertical entry -> bend) removes the inlet lip/gap
    [canis.scad, canis_all.stl, chute.stl]
2026-06-29 Chute: single smooth channel (remove the tube-in-tube internal step)
    [canis.scad, canis_all.stl, chute.stl]
2026-06-29 Add original build reference photos (metal-chassis prototype)
2026-06-30 Add L298N motor firmware, 3-ultrasonic sensing, Pi-camera vision, test/setup docs
    - Treat_Dispenser_CANIS: L298N differential drive (FWD/BACK/LEFT/RIGHT/STOP)
    with a fail-safe motion watchdog; stop motors at dispense start
    - CANIS_Core: real CORRECTION orient (pulsed, EXPOSURE_LEVEL-gated, watchdog-fed);
    3 ultrasonics (L/C/R) read sequentially with local-bearing steering;
    freed GPIO14 by setting Serial2 RX to -1
    - Sensors_Test: standalone bench test for PIR + 3 ultrasonics
    - vision/detect.py: Pi Camera (picamera2) backend, directional zone labels, --snap
    - docs: README phase status (motors + vision hardware-proven), WIRING (3-sensor
    pins, L298N implemented, Pi-on-own-bank power plan)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
    [CANIS_Core.ino, Sensors_Test.ino, Treat_Dispenser_CANIS.ino, detect.py]
2026-06-30 Add print-ready v2 CAD: flap-gate dispenser, fit/labels, angled 3-ultrasonic shell
    Duplicate of canis.scad (canis_v2.scad) — originals untouched. STLs in stl_v2/,
    renders in preview_v2/, BUILD_GUIDE_v2.md.
    - Dispenser: rotating disc -> FLAP GATE (servo swings a paddle ~80deg off a gate
    hole). Matches the tested firmware (OPEN=0/CLOSED=80) -> no firmware change.
    - Deck: every component fits; added a 4xAA cradle [5], under-deck power-bank strap
    mount [6], wire-routing slots, and engraved number labels [1-6].
    - Shelf: number labels [7-9].
    - Shell: paw kept (camera + SR04M-2 centre + PIR); 2x HC-SR04 on angled
    front-left/right openings (~32deg) for L/C/R bearing. sensor_plate updated.
    -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
    [canis_v2.scad, castor.stl, chute.stl, deck.stl, dispenser.stl, flap.stl, lid.stl, sensor_plate.stl]
2026-06-30 Add modern-angular shell variant (canis_v3.scad)
    New duplicate; canis_v2.scad + originals untouched. Only the shell changed —
    all internals (deck, dispenser, sensors, numbered labels) identical to v2.
    - Shell: bulbous dome -> low faceted slab (crisp vertical sides, 45deg chamfered
    top edge, rear-biased flat top). Recessed front sensor-face panel
    (camera + SR04M-2 + PIR); 2x HC-SR04 on angled front-corner bores.
    - Funnel opening + fan grille on top; CANIS deboss on the rear face.
    - Export: stl_v3/shell.stl (use stl_v2/ for all other parts).
    [canis_v3.scad, shell.stl]
2026-07-07 Restructure repo for public release: polished root README + full optimized/ tree
    - Promote the welfare-first design README (three-tier architecture, exposure
    gating, safety table) to the repository root, with the CI status badge
    - Add GitHub Actions workflow running the 51-test pytest suite on push/PR
    - Add the complete optimized/ tree: hardened ESP32/Arduino firmware, single-
    source config with parity test, dashboard (event log + auth), vision,
    architecture/safety docs, 11-chapter guidebook, study protocol + tooling,
    reviews, and paper draft v2 with figures
    - Add hardware v4 CAD (OpenSCAD + STLs + print checks) and gcode exports
    Originals kept as-built alongside optimized/ so the b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
    [castor.gcode.3mf, deck.gcode.3mf, dispenser.gcode.3mf, lid.gcode.3mf, sensor_plate.gcode.3mf, shelf.gcode.3mf, shell.gcode.3mf]
2026-07-19 Add CBF safe-motion control package, YOLO vision, and mobile-gated firmware
    Software for the stationary->mobile upgrade, all flag-gated behind
    CANIS_MOBILE_ENABLED=0 so the stationary station is unaffected.
    - control/: estimator, comfort margin, barrier-QP (cbf), reward, motion_controller
    - vision/: detect_yolo.py (robot's-eye, now default) and detect_fixed.py
    (fixed room camera); detect.py kept as the ArUco fallback
    - firmware: PCNT encoders, /telemetry and /motion relay on ESP32; VEL executor on Uno
    - dashboard: /telemetry and /motion routes plus the controller tick loop
    - tests: dashboard motion coverage; suite is 88/88
    Corrects the sensor inventory: there is no ToF. The third sensor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
2026-07-19 Add v4 STLs, sliced print files, and slicer settings
    Historical record of the print phase, which is now closed: the build uses the
    metal chassis plus parts already in hand. shelf_plain and dispenser_split are
    kept as unused options only.
    [castor_chute.gcode.3mf, deck_A.gcode.3mf, deck_B.gcode.3mf, deck_onepiece.gcode.3mf, lid_sensor.gcode.3mf, shell_onepiece.gcode.3mf]
2026-07-19 Scrub home SSID from tracked files; remove SSH user and IPs from handoff doc
    Closes the open item in reviews/SECRET_AUDIT.md: the real network name was
    still in WiFi_Scan_Test/ and WiFi_Connect_Test/ comments, in guidebook ch.13,
    and quoted in the audit doc itself. All replaced with <HOME_SSID>.
    Also removes the SSH user/host and LAN IPs I had put in RESUME_HERE.md - this
    repo is public, so operating credentials belong in memory and the gitignored
    arduino_secrets.h, not in a tracked file. The doc now points there instead.
    The SSID literal remains in git history from earlier commits; the WiFi password
    was never committed, so severity is low and a history rewrite is left as the
    user's call.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
    [WiFi_Connect_Test.ino, WiFi_Scan_Test.ino]
2026-07-19 Track carried-forward open items in RESUME_HERE
    Adds section 5a so the loose ends survive between sessions instead of living
    only in conversation: the unpushed commits, the SSID still in git history, the
    Pi being behind on code, the unwritten reward-contingency fix, and the open
    mobile-camera decision. Each is stated with why it matters, so a future session
    can judge urgency rather than just seeing a checkbox.
2026-07-19 Correct the reward-contingency claim: no fix needed in default PLACE mode
    An earlier note (carried into RESUME_HERE) said treats fire from a free
    clock-driven timer alongside the vision reward. Traced it against the code and
    that is false as configured: the calm reward is GUARD-only (CANIS_Core.ino:726)
    and the default mode is PLACE (canis_config.h:140), which gates every treat on
    visionActive behind a 4s TTL. Reward is already dog-contingent, so nothing
    blocks the study here.
    Records the caveat that does hold: in GUARD mode calm rewards drop into an empty
    room, since CALM does not imply the dog is present. Inert for a PLACE-mode study,
    must be fixed if a session ever switches to GUARD.
    No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
2026-07-19 Correct camera architecture from open decision to implemented config switch
    The user had already decided to build both B and C, and the code reflects it:
    CANIS_CAMERA_MODE selects onboard / esp32cam_stream / fixed_room, with
    detect_yolo.py serving A+B and detect_fixed.py serving C, all POSTing the same
    detection contract. RESUME_HERE listed it as an unmade decision, which was
    stale and would have sent a future session to re-decide settled work.
    Also records the mode-C gotcha already noted in canis_config.h: with roam
    enabled the robot can wander out of the fixed camera's frame and lose
    detection until it returns.
2026-07-19 Add a provenance convention so stale claims cannot drift unnoticed
    Two wrong claims reached the user today by the same route: a note written
    before the work was finished got copied forward as fact without re-reading the
    code. Fixing the two instances does not stop the third, so this adds the
    structural guard.
    RESUME_HERE gains section 0: every claim is tagged [code] (verified against the
    repo, with file:line to re-check) or [bench] (reported from the hardware,
    unverifiable here, may be stale). The status table, wiring pins and operating
    facts are tagged accordingly - pin assignments re-verified against
    CANIS_Core.ino:119-121, the YOLO target-class env var against
    detect_yolo.py:389, and the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
2026-10-04 Ignore build output and the camera sketch, which embed the WiFi credentials
2026-10-04 Note that the centre ultrasonic is parked and PLAY has no forward sensor
2026-10-11 Reorganise the repository: flatten the tree, rewrite the README, bring the docs up to date with the rebuilt robot
    [canis.scad, canis_all.stl, canis_v2.scad, canis_v3.scad, canis_v4.scad, castor.gcode.3mf, castor.stl, castor_chute.gcode.3mf]
2026-10-12 Fix line references and stray markup in the docs; point the old OPTIMIZATIONS references at DESIGN_DECISIONS
    [CANIS_Core.ino, canis_config.h]
2026-10-13 Add an integrated through-hole mainboard (ATmega328P, L298N, 5 V buck, ESP32 sockets) with generator, router, netlist check and fab files
    [canis_main-B_Cu.gbr, canis_main-B_Mask.gbr, canis_main-B_Silkscreen.gbr, canis_main-Edge_Cuts.gbr, canis_main-F_Cu.gbr, canis_main-F_Mask.gbr, canis_main-F_Silkscreen.gbr, canis_main-drl_map.gbr]
2026-10-13 Mainboard: wire to the existing L298N module through a header instead of carrying the bare chip
    [canis_main-B_Cu.gbr, canis_main-B_Mask.gbr, canis_main-B_Silkscreen.gbr, canis_main-Edge_Cuts.gbr, canis_main-F_Cu.gbr, canis_main-F_Mask.gbr, canis_main-F_Silkscreen.gbr, canis_main-drl_map.gbr]
2026-10-30 README: update status with encoder test, closed-loop drive and the two-week trial with Shifu
2026-10-30 Keep personal notes, CREST material and the paper draft out of the public repo
